DimsRoot/MUX-uSD-PCB/Board_V01.pdf

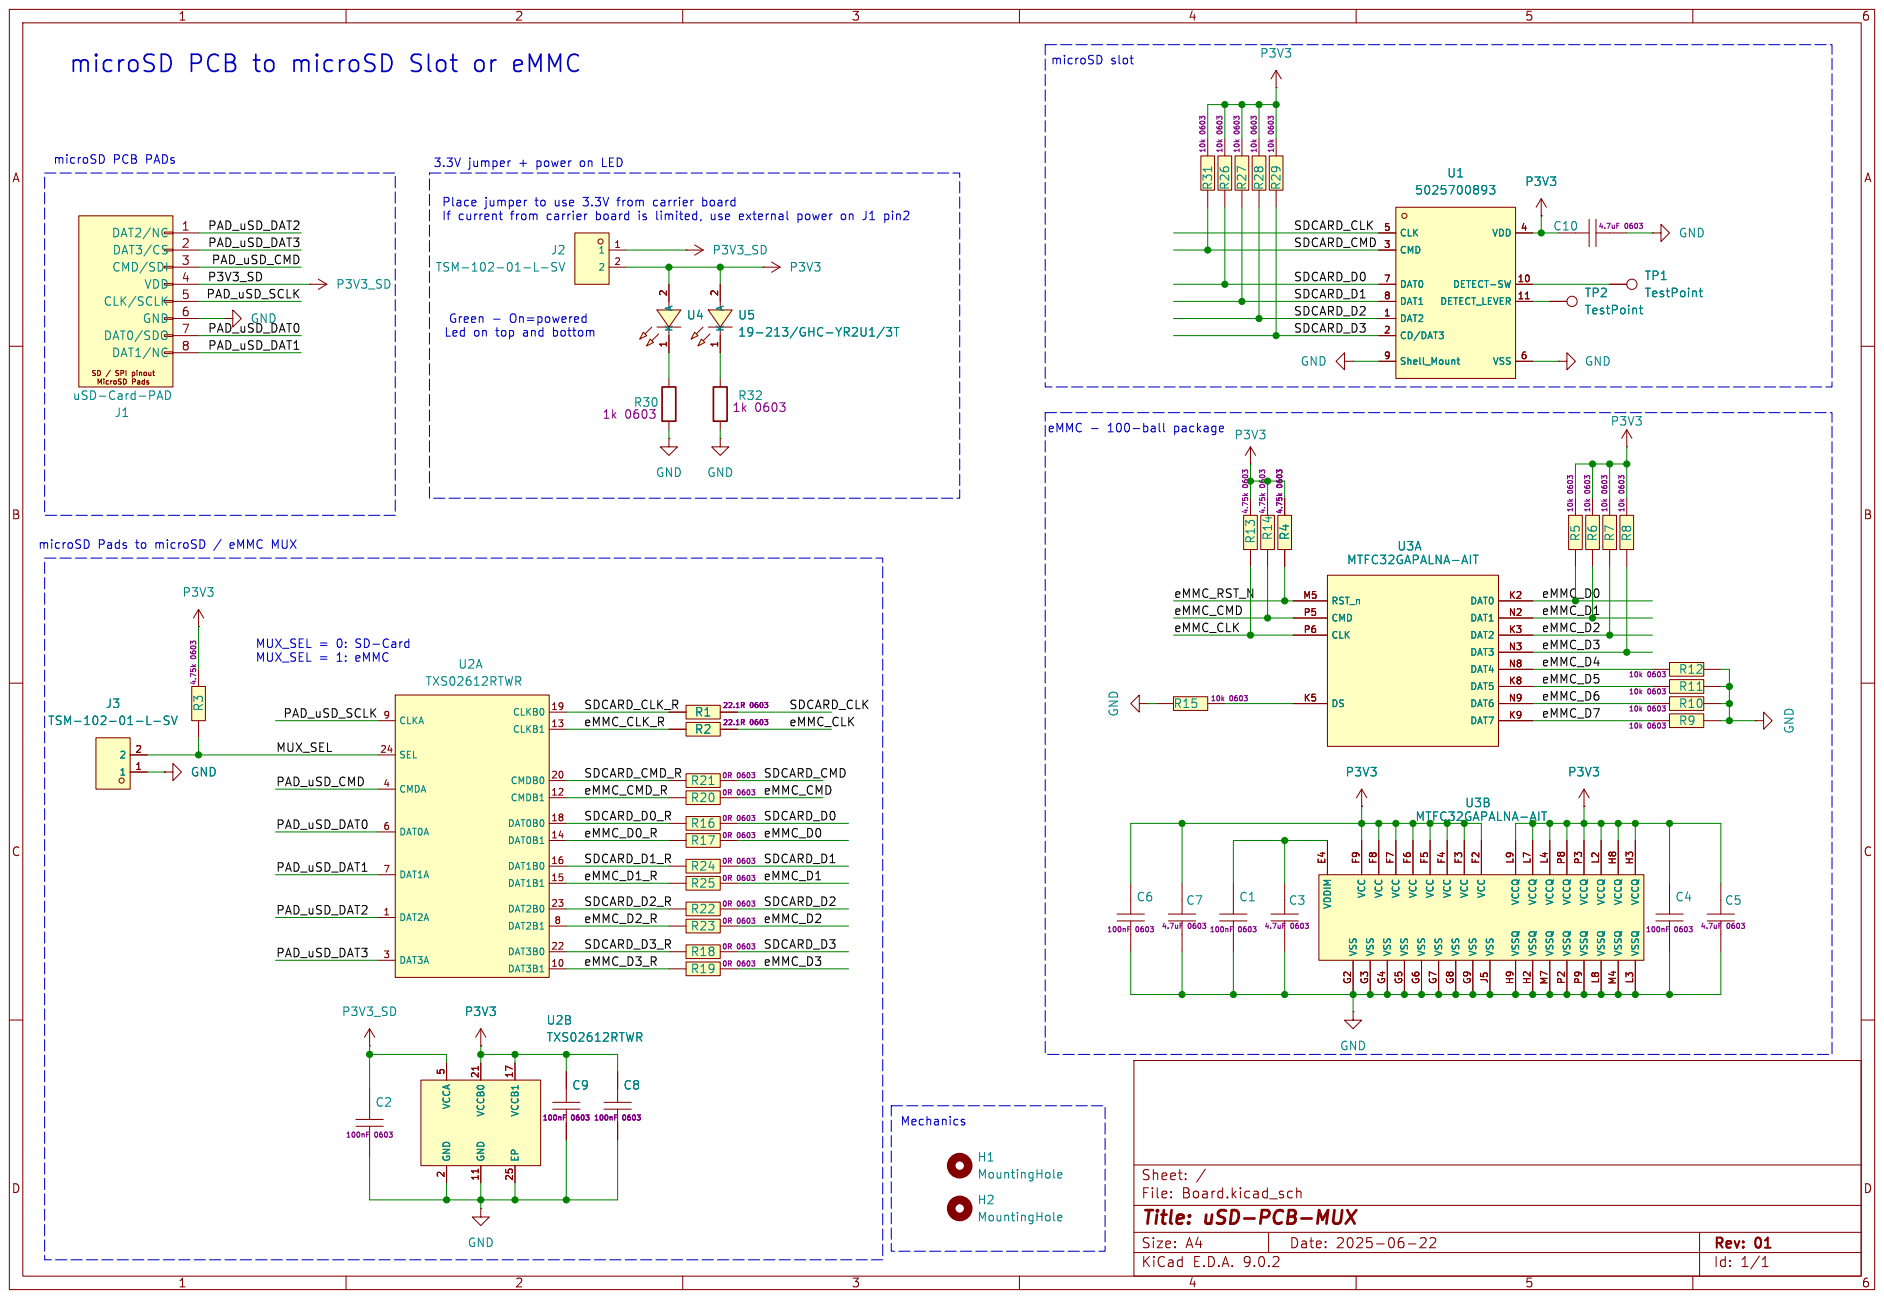
[picture p1: page 1]

MUX_SEL = 0: SD-Card MUX_SEL = 1: eMMC microSD Pads to microSD / eMMC MUX microSD PCB PADs microSD PCB to microSD Slot or eMMC

3.3V jumper + power on LED
PAD_uSD_DAT1 MUX_SEL

Led on top and bottom

Id: 1/1 Title: uSD-PCB-MUX
