DimsRoot/MUX-uSD-PCB/Board.kicad_pcb

## KiCad design Board.kicad_pcb (2025-06-23)

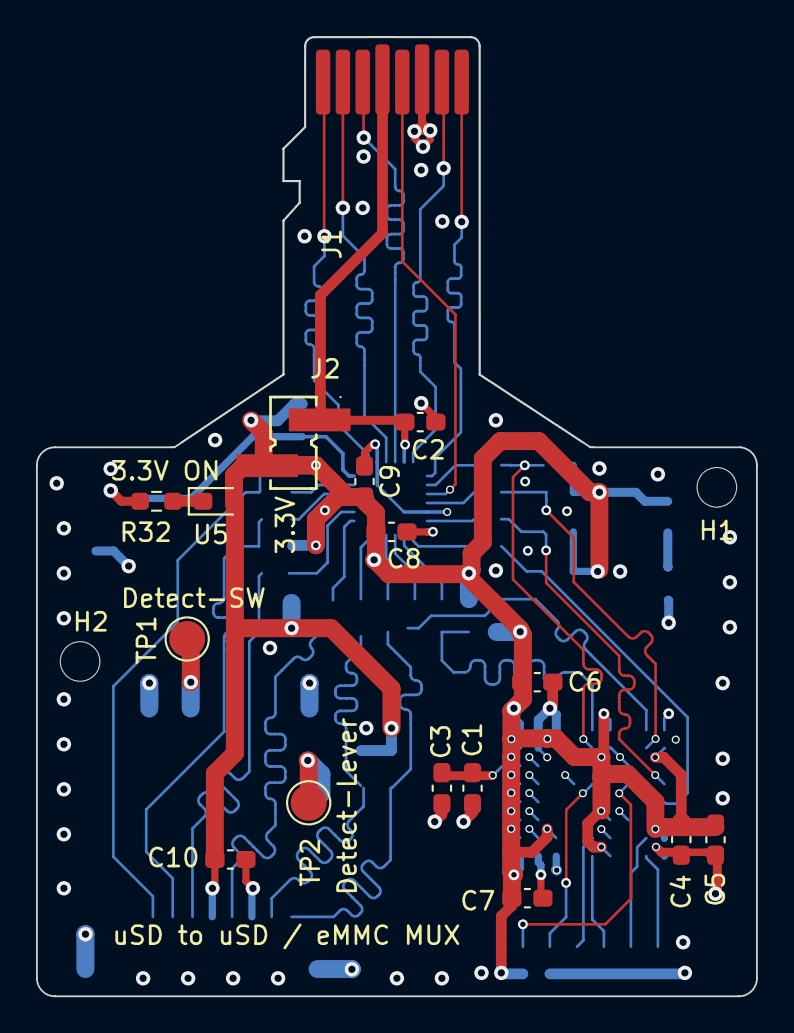
[picture p2: board Board.kicad_pcb from above]

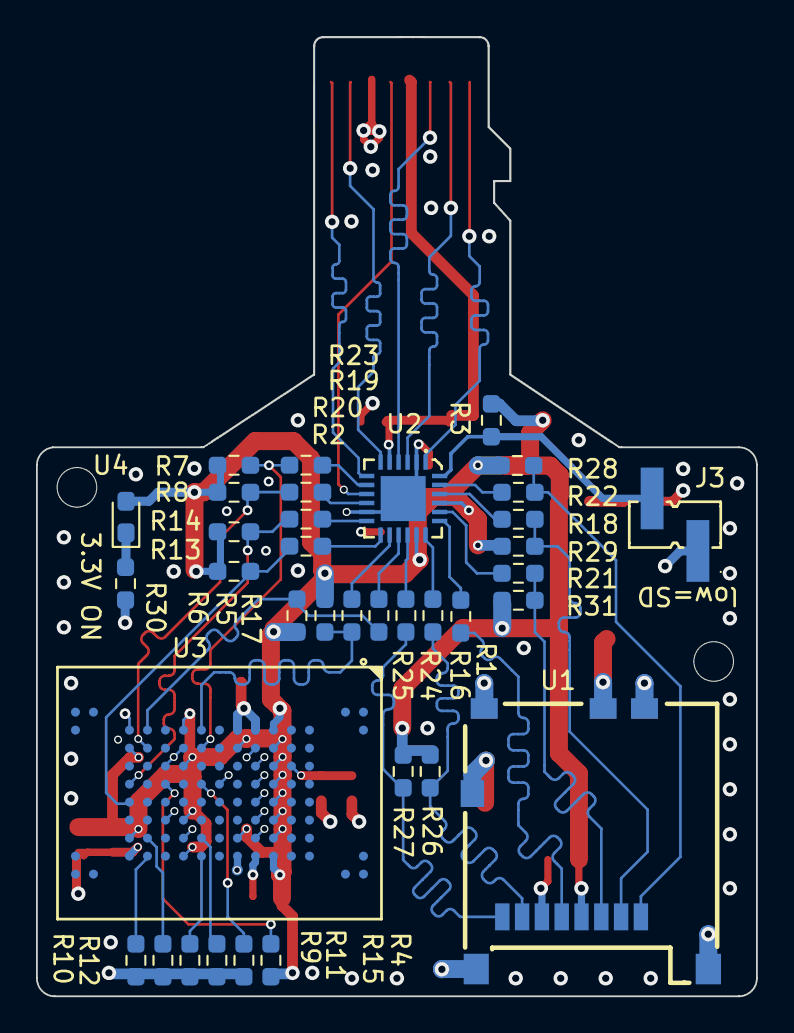
[picture p3: board Board.kicad_pcb from below]

Board: 4 copper layers, 40.0 x 53.3 mm, 54 parts (36 on the bottom side), 45 nets.

Parts:
C1, C2, C4, C6, C8, C9: CC0603KRX7R9BB104; C_0603_1608Metric_Pad1.08x0.95mm_HandSolder
C3, C5, C7, C10: CC0603MRX7R5BB475; C_0603_1608Metric_Pad1.08x0.95mm_HandSolder
H1, H2: MountingHole; MountingHole_2.2mm_M2
J1: uSD-Card-PAD; uSD-CARD-PAD-wOutline
J2, J3: TSM-102-01-L-SV; CONN-SMD_TSM-102-01-L-SV
R1, R2: RC0603FR-0722R1L; R_0603_1608Metric_Pad0.98x0.95mm_HandSolder
R3, R4, R13, R14: RC0603FR-074K75L; R_0603_1608Metric_Pad0.98x0.95mm_HandSolder
R5, R6, R7, R8, R9, R10, R11, R12, R15, R26, R27, R28, R29, R31: RC0603JR-0710KL; R_0603_1608Metric_Pad0.98x0.95mm_HandSolder
R16, R17, R18, R19, R20, R21, R22, R23, R24, R25: RC0603JR-070RL; R_0603_1608Metric_Pad0.98x0.95mm_HandSolder
R30, R32: RC0603JR-071KL; R_0603_1608Metric_Pad0.98x0.95mm_HandSolder
TP1, TP2: TestPoint; TestPoint_Pad_D2.0mm
U1: 5025700893; TF-SMD_5025700893
U2: TXS02612RTWR; WQFN-24_L4.0-W4.0-P0.50-TL-EP2.5
U3: MTFC32GAPALNA-AIT; TBGA-100_L18.0-W14.0-P1.00-TL_MTFC32GAPALNA-AIT
U4, U5: 19-213/GHC-YR2U1/3T; LED_0603_1608Metric_Pad1.05x0.95mm_HandSolder

Connections:
/MUX_SEL: J3.2, R3.1, U2.24 (SEL)
/PAD_uSD_CMD: J1.3 (CMD/SDI), U2.4 (CMDA)
/PAD_uSD_DAT0: J1.7 (DAT0/SDO), U2.6 (DAT0A)
/PAD_uSD_DAT1: J1.8 (DAT1/NC), U2.7 (DAT1A)
/PAD_uSD_DAT2: J1.1 (DAT2/NC), U2.1 (DAT2A)
/PAD_uSD_DAT3: J1.2 (DAT3/CS), U2.3 (DAT3A)
/PAD_uSD_SCLK: J1.5 (CLK/SCLK), U2.9 (CLKA)
/SDCARD_CLK: R1.2, U1.5 (CLK)
/SDCARD_CLK_R: R1.1, U2.19 (CLKB0)
/SDCARD_CMD: R21.2, R31.1, U1.3 (CMD)
/SDCARD_CMD_R: R21.1, U2.20 (CMDB0)
/SDCARD_D0: R16.2, R26.1, U1.7 (DAT0)
/SDCARD_D0_R: R16.1, U2.18 (DAT0B0)
/SDCARD_D1: R24.2, R27.1, U1.8 (DAT1)
/SDCARD_D1_R: R24.1, U2.16 (DAT1B0)
/SDCARD_D2: R22.2, R28.1, U1.1 (DAT2)
/SDCARD_D2_R: R22.1, U2.23 (DAT2B0)
/SDCARD_D3: R18.2, R29.1, U1.2 (CD/DAT3)
/SDCARD_D3_R: R18.1, U2.22 (DAT3B0)
/eMMC_CLK: R2.2, R13.1, U3.P6 (CLK)
/eMMC_CLK_R: R2.1, U2.13 (CLKB1)
/eMMC_CMD: R14.1, R20.2, U3.P5 (CMD)
/eMMC_CMD_R: R20.1, U2.12 (CMDB1)
/eMMC_D0: R5.1, R17.2, U3.K2 (DAT0)
/eMMC_D0_R: R17.1, U2.14 (DAT0B1)
/eMMC_D1: R6.1, R25.2, U3.N2 (DAT1)
/eMMC_D1_R: R25.1, U2.15 (DAT1B1)
/eMMC_D2: R7.1, R23.2, U3.K3 (DAT2)
/eMMC_D2_R: R23.1, U2.8 (DAT2B1)
/eMMC_D3: R8.1, R19.2, U3.N3 (DAT3)
/eMMC_D3_R: R19.1, U2.10 (DAT3B1)
/eMMC_D4: R12.2, U3.N8 (DAT4)
/eMMC_D5: R11.2, U3.K8 (DAT5)
/eMMC_D6: R10.2, U3.N9 (DAT6)
/eMMC_D7: R9.2, U3.K9 (DAT7)
/eMMC_RST_N: R4.1, U3.M5 (RST_n)
GND: C1.1, C2.1, C3.2, C4.1, C5.2, C6.1, C7.2, C8.1, C9.1, C10.1, J1.6 (GND), J3.1, R9.1, R10.1, R11.1, R12.1, R15.1, R30.2, R32.2, U1.6 (VSS), U1.9 (Shell_Mount), U2.2 (GND), U2.11 (GND), U2.25 (EP), U3.G2 (VSS), U3.G3 (VSS), U3.G4 (VSS), U3.G5 (VSS), U3.G6 (VSS), U3.G7 (VSS), U3.G8 (VSS), U3.G9 (VSS), U3.H2 (VSSQ), U3.H9 (VSSQ), U3.J5 (VSS), U3.L3 (VSSQ), U3.L8 (VSSQ), U3.M4 (VSSQ), U3.M7 (VSSQ), U3.P2 (VSSQ), U3.P9 (VSSQ)
unnamed: TP1.1, U1.10 (DETECT-SW)
unnamed: TP2.1, U1.11 (DETECT_LEVER)
unnamed: R15.2, U3.K5 (DS)
unnamed: C1.2, C3.1, U3.E4 (VDDIM)
unnamed: R30.1, U4.1 (K)
unnamed: R32.1, U5.1 (K)
P3V3: C4.2, C5.1, C6.2, C7.1, C8.2, C9.2, C10.2, J2.2, R3.2, R4.2, R5.2, R6.2, R7.2, R8.2, R13.2, R14.2, R26.2, R27.2, R28.2, R29.2, R31.2, U1.4 (VDD), U2.17 (VCCB1), U2.21 (VCCB0), U3.F2 (VCC), U3.F3 (VCC), U3.F4 (VCC), U3.F5 (VCC), U3.F6 (VCC), U3.F7 (VCC), U3.F8 (VCC), U3.F9 (VCC), U3.H3 (VCCQ), U3.H8 (VCCQ), U3.L2 (VCCQ), U3.L4 (VCCQ), U3.L7 (VCCQ), U3.L9 (VCCQ), U3.P3 (VCCQ), U3.P8 (VCCQ), U4.2 (A), U5.2 (A)
P3V3_SD: C2.2, J1.4 (VDD), J2.1, U2.5 (VCCA)
