DimsRoot/MUX-uSD-PCB/(commit log)

2025-06-22 Initial version of the uSD-eMMC-Mux board
    [Board-B_Cu.gbr, Board-B_Mask.gbr, Board-B_Paste.gbr, Board-B_Silkscreen.gbr, Board-Edge_Cuts.gbr, Board-F_Cu.gbr, Board-F_Mask.gbr, Board-F_Paste.gbr]
2025-06-23 update via drilling size and prod files
    [Board-B_Cu.gbr, Board-B_Mask.gbr, Board-B_Paste.gbr, Board-B_Silkscreen.gbr, Board-Edge_Cuts.gbr, Board-F_Cu.gbr, Board-F_Mask.gbr, Board-F_Paste.gbr]
